xioTechnologies/DressCode-PCB/README.md

DressCode-PCB
=============

A sewable circuit for making LEDs respond to music.  [Firmware](https://github.com/xioTechnologies/DressCode-Firmware) source files are available on GitHub.  See [original post](http://www.x-io.co.uk/dresscode/) for more information.
