xioTechnologies/DressCode-PCB/DressCode BOM.xlsx

Name | Device | Qty | Unit price | Total price
R1, R2, R3, R4, R5, R6, R7, R8 | 2.2k, 0805 (http://uk.rs-online.com/web/p/surface-mount-fixed-resistors/2230477/) | 8 | £0.01 | £0.12
R9, R10, R11 | 100R, 0805 (http://uk.rs-online.com/web/p/surface-mount-fixed-resistors/2230297/) | 3 | £0.01 | £0.02
C1, C3, C4, C5, C6 | 10u, 0805 (http://uk.rs-online.com/web/p/ceramic-multilayer-capacitors/7236004/) | 5 | £0.07 | £0.37
C2 | 10n, 0805 (http://uk.rs-online.com/web/p/ceramic-multilayer-capacitors/2644371/) | 1 | £0.02 | £0.02
Q1, Q2, Q3 | 2N7002 (N-channel FET) (http://uk.rs-online.com/web/p/mosfet-transistors/7527773/) | 3 | £0.03 | £0.08
U3 | MCP6G02-E/SN (SGA) (http://uk.rs-online.com/web/p/programmable-gain-amplifiers/0402986/) | 1 | £0.31 | £0.31
U1, U2 | MCP6S21-I/SN (PGA) (http://uk.rs-online.com/web/p/programmable-gain-amplifiers/0403193/) | 2 | £0.69 | £1.37
M1 | Microphone (http://uk.rs-online.com/web/p/condenser-microphone-components/7243134/) | 1 | £0.46 | £0.46
M2 | Microphone (https://uk.rs-online.com/web/p/condenser-microphone-components/7243122/) | 1 | £0.56 | £0.56
U4 | PIC24FV16KA304-I/PT (http://uk.rs-online.com/web/p/microcontrollers/7421176/) | 1 | £1.91 | £1.91
U5 | MCP73832T-2ACI/OT (battery charger) (http://uk.rs-online.com/web/p/battery-charge-controller-ics/7386364/) | 1 | £0.38 | £0.38
USB1 | Micro USB socket (http://uk.rs-online.com/web/p/micro-usb-connectors/7025475/) | 1 | £0.52 | £0.52
JST1 | JST battery connector (https://www.sparkfun.com/products/8612) | 1 | £0.49 | £0.49
SW1 | Slide switch (http://uk.farnell.com/c-k-components/pcm12smtr/switch-spdt-0-3a-6vdc-smd/dp/9575146RL) | 1 | £0.62 | £0.62
 |  |  | Total: | £7.24
Only one microphone should be populated, M1 or M2
