xioTechnologies/DressCode-PCB/DressCode Schematic.pdf

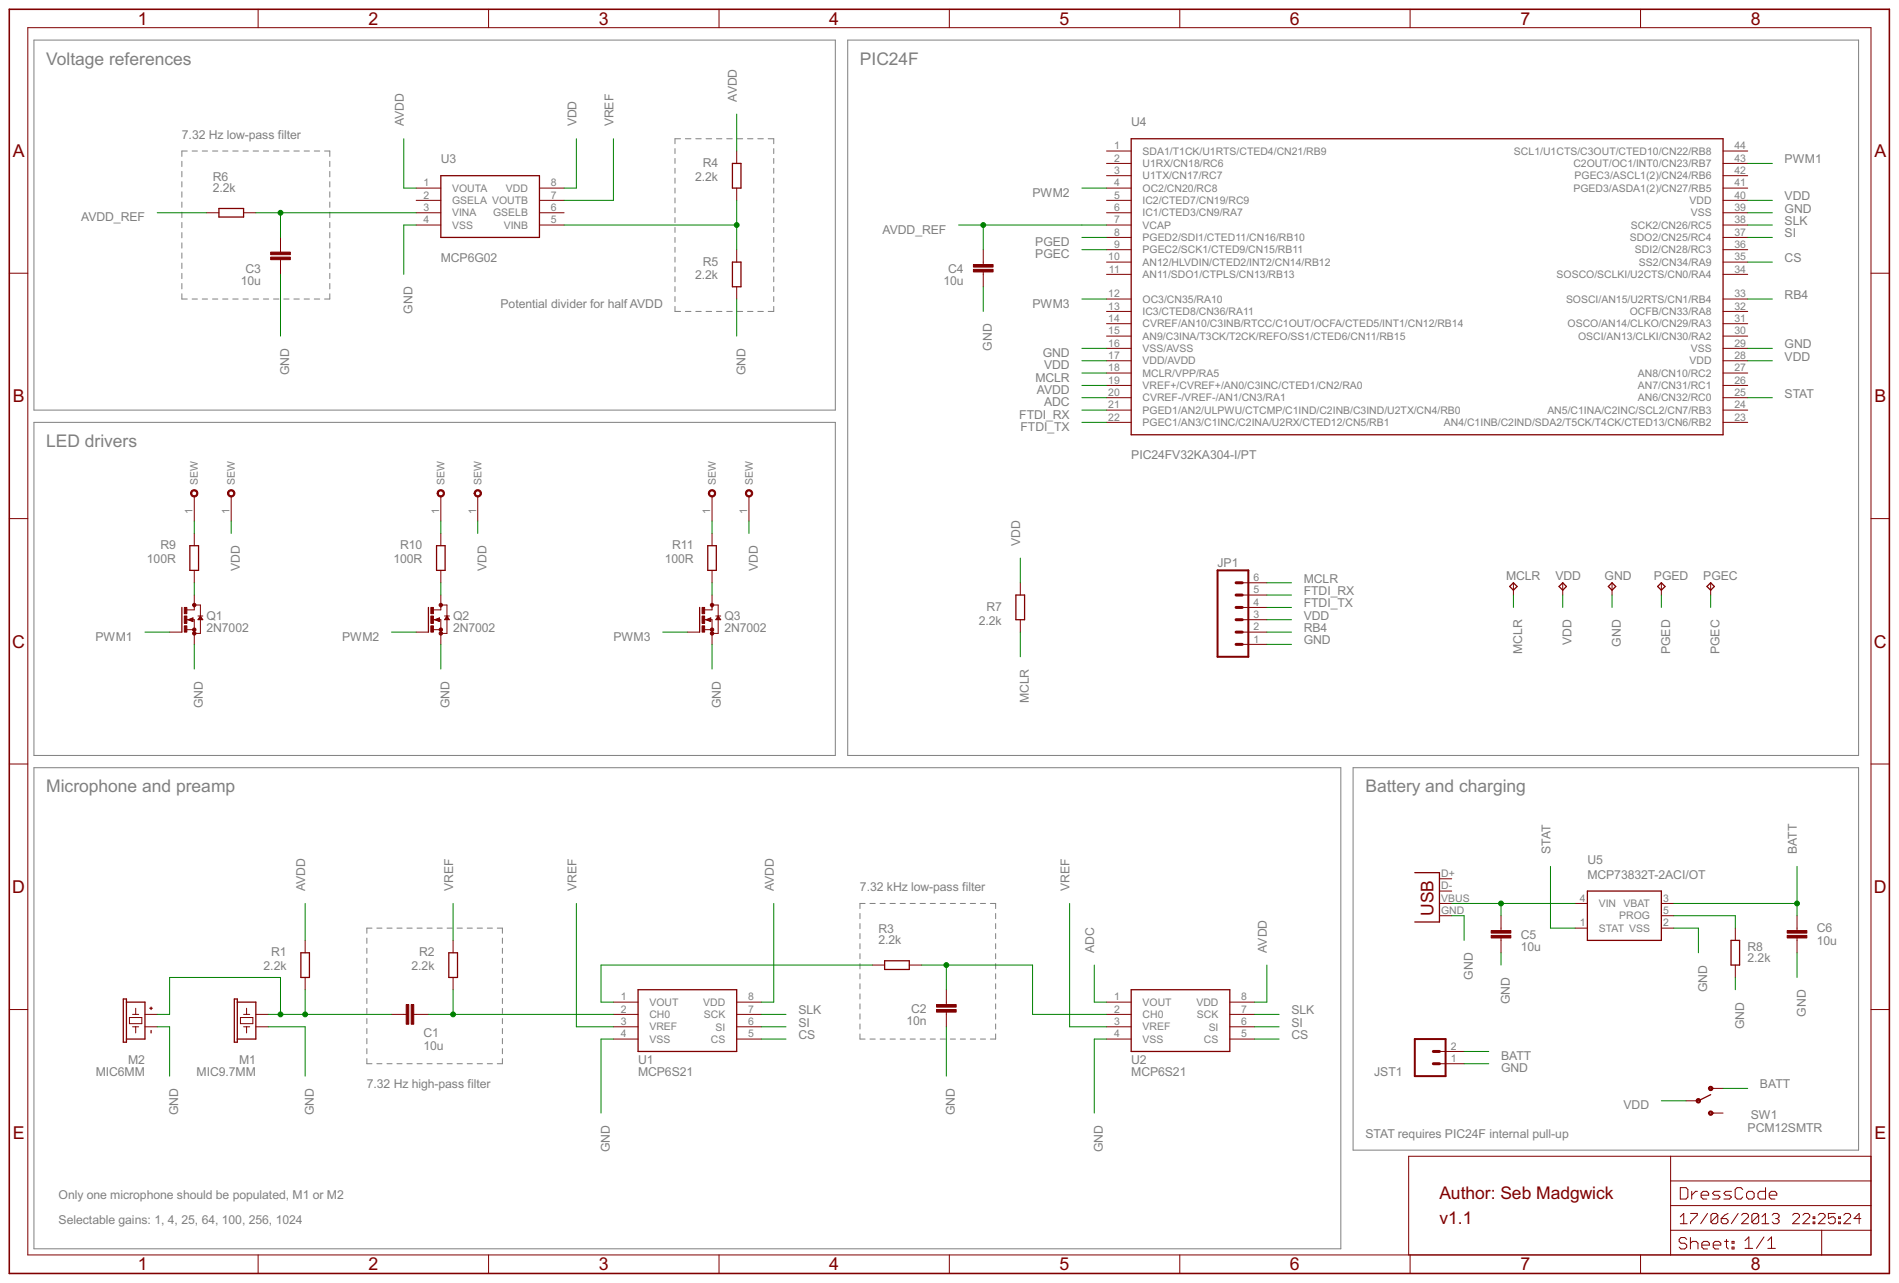
[picture p1: page 1]

7.32 Hz low-pass filter

Potential divider for half AVDD

BATT BATT Author: Seb Madgwick

7.32 kHz low-pass filter

7.32 Hz high-pass filter
