xioTechnologies/DressCode-PCB/DressCode PCB.pdf

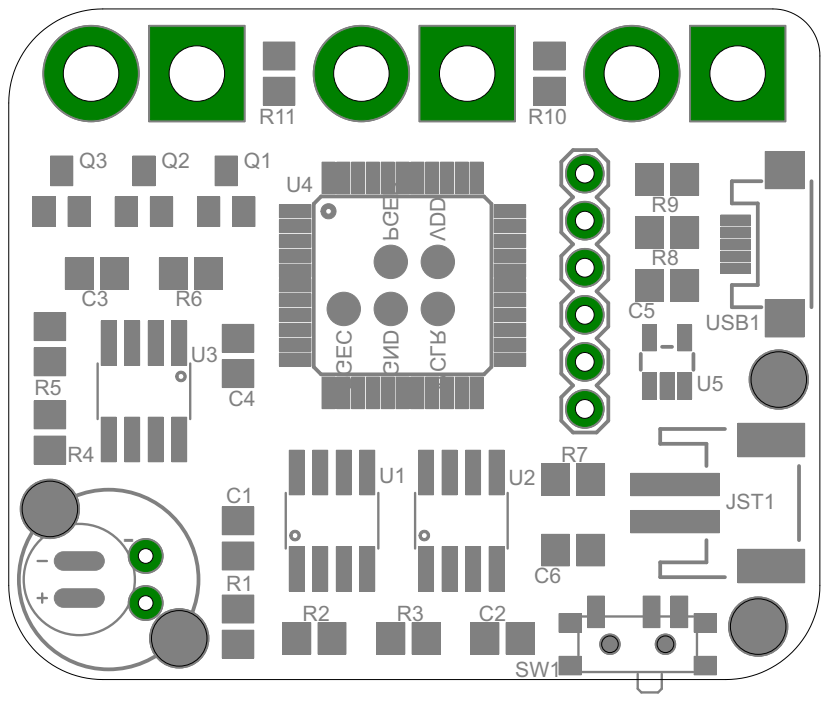
[picture p2: page 1]
