xioTechnologies/DressCode-PCB/DressCode.brd

## EAGLE design DressCode.brd (2013-06-20)

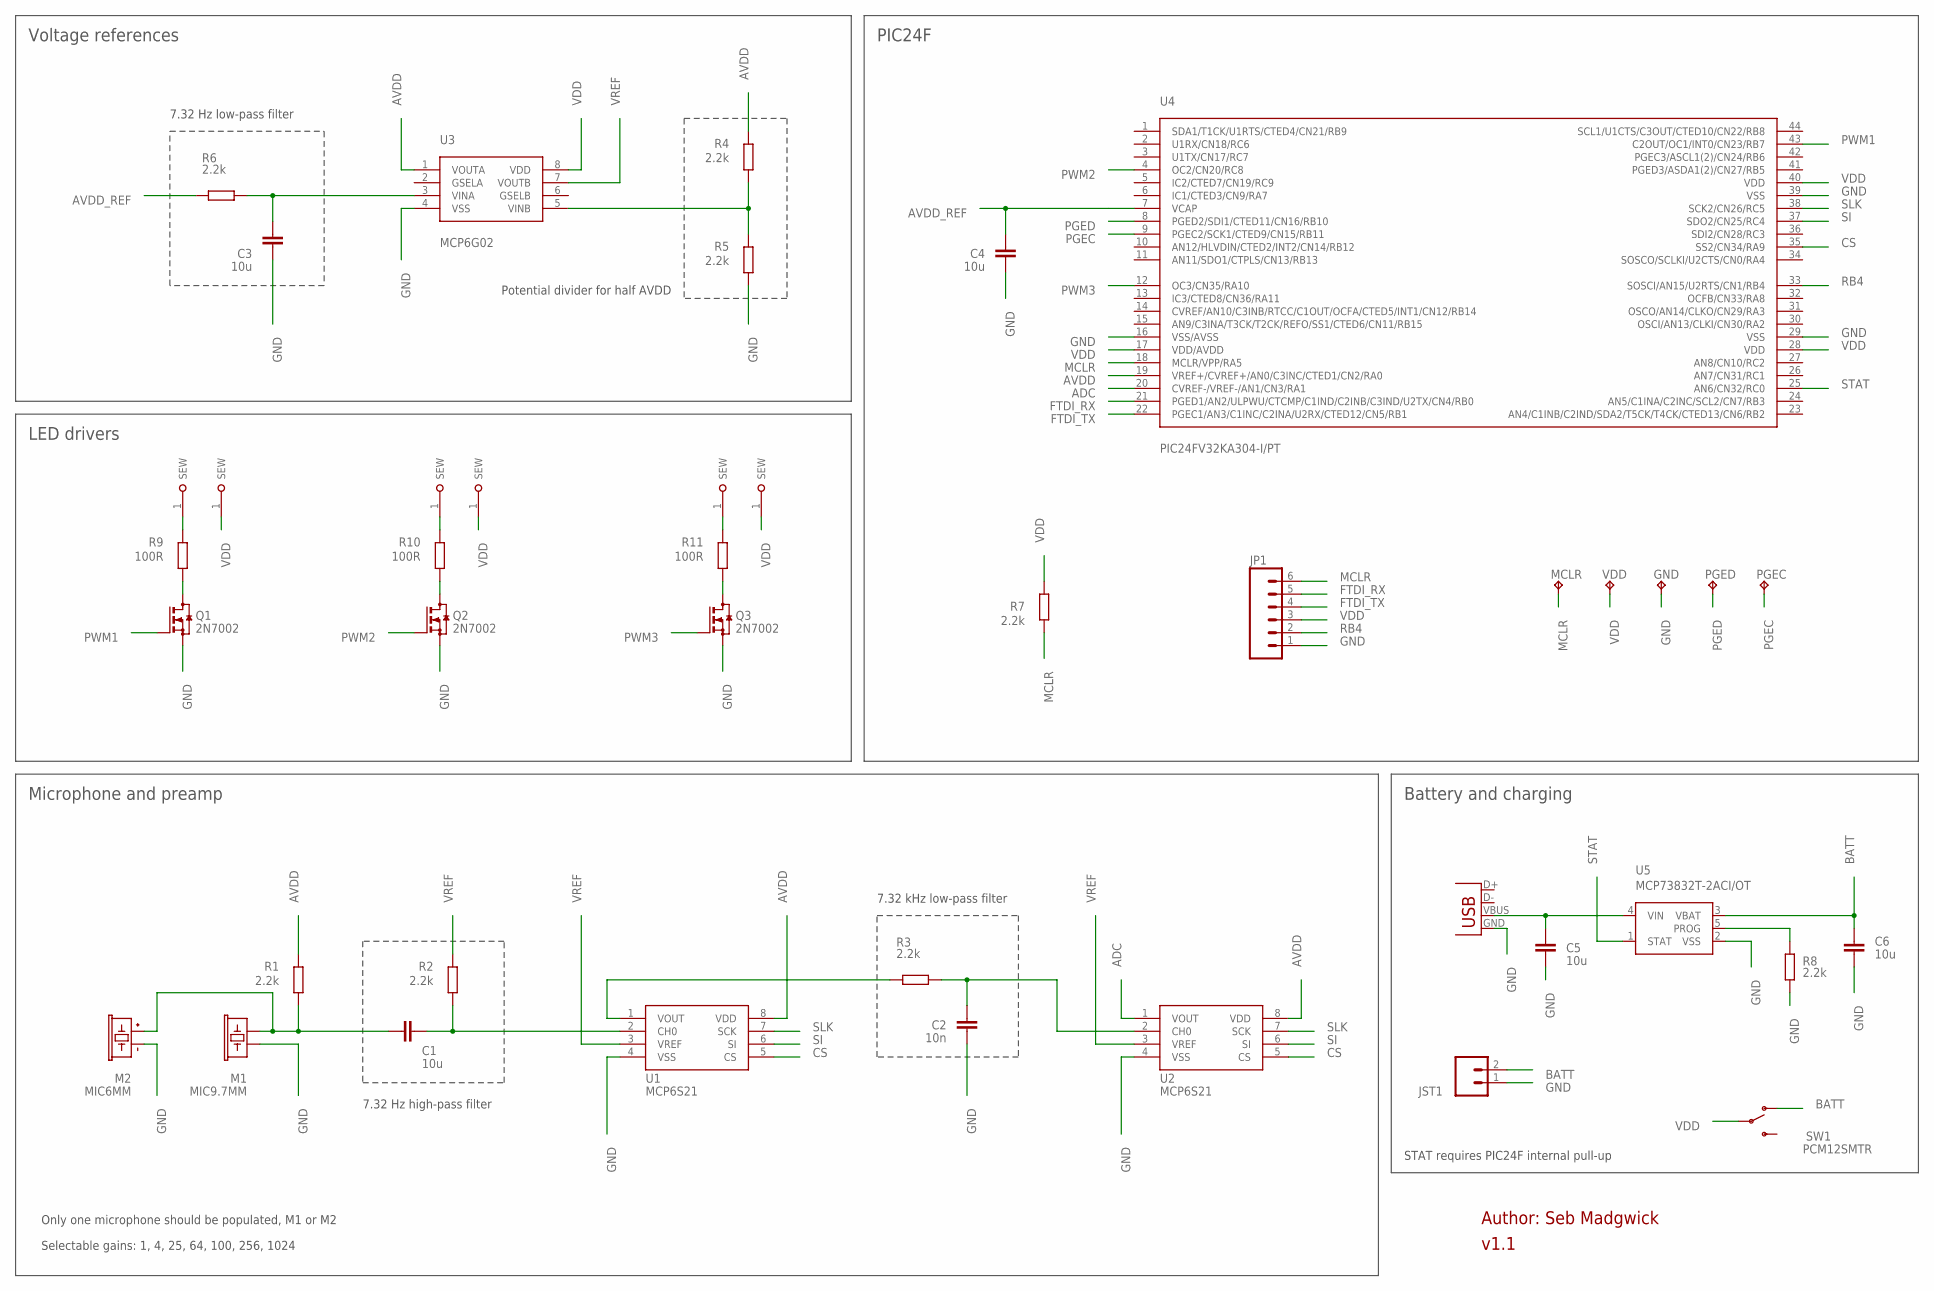
[picture p3: schematic DressCode.sch]

Parts:
C1, C3, C4, C5, C6: 10u; C0805
C2: 10n; C0805
GND: TPTP16R; TP16R
JP1: M06SIP; 1X06
JST1: M02-JST-2MM-SMT; JST-2-SMD
M1: MIC9.7MM; MIC-9.7MM
M2: MIC6MM; MIC-SMD
MCLR: TPTP16R; TP16R
PGEC: TPTP16R; TP16R
PGED: TPTP16R; TP16R
Q1, Q2, Q3: 2N7002; SOT23
R1, R2, R3, R4, R5, R6, R7, R8: 2.2k; R0805
R9, R10, R11: 100R; R0805
SW1: PCM12SMTR
U1, U2: MCP6S21; SOIC-8
U3: MCP6G02; SOIC-8
U4: PIC24FV32KA304-I/PT; TQFP44
U5: MCP73832T-2ACI/OT; SOT23-5
U$4, U$5, U$6: DRESSCODE_SEW_PADC; DRESSCODE_SEW_PAD_CIRC
U$7, U$8, U$10: DRESSCODE_SEW_PADS; DRESSCODE_SEW_PAD_SQR
USB1: USB-MICROB
VDD: TPTP16R; TP16R

Connections:
ADC: U2.1 (VOUT), U4.20 (CVREF-/VREF-/AN1/CN3/RA1)
AVDD: R1.2, R4.2, U1.8 (VDD), U2.8 (VDD), U3.1 (VOUTA), U4.19 (VREF+/CVREF+/AN0/C3INC/CTED1/CN2/RA0)
AVDD_REF: C4.2, R6.1, U4.7 (VCAP)
BATT: C6.2, JST1.2, SW1.1 (O), U5.3 (VBAT)
CS: U1.5 (CS), U2.5 (CS), U4.35 (SS2/CN34/RA9)
FTDI_RX: JP1.5, U4.21 (PGED1/AN2/ULPWU/CTCMP/C1IND/C2INB/C3IND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)
FTDI_TX: JP1.4, U4.22 (PGEC1/AN3/C1INC/C2INA/U2RX/CTED12/CN5/R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)
GND: C2.2, C3.1, C4.1, C5.1, C6.1, GND.TP, JP1.1, JST1.1, M1.2, M2.-, Q1.2 (S), Q2.2 (S), Q3.2 (S), R5.1, R8.1, U1.4 (VSS), U2.4 (VSS), U3.4 (VSS), U4.16 (VSS/AVSS), U4.29 (VSS), U4.39 (VSS), U5.2 (VSS), USB1.GND
MCLR: JP1.6, MCLR.TP, R7.1, U4.18 (MCLR/VPP/RA5)
unnamed: C1.1, M1.1, M2.+, R1.1
unnamed: C1.2, R2.1, U1.2 (CH0)
unnamed: C2.1, R3.2, U2.2 (CH0)
unnamed: R3.1, U1.1 (VOUT)
unnamed: C3.2, R6.2, U3.3 (VINA)
unnamed: R4.1, R5.2, U3.5 (VINB)
unnamed: Q1.3 (D), R9.1
unnamed: Q2.3 (D), R10.1
unnamed: Q3.3 (D), R11.1
unnamed: R9.2, U$7.1
unnamed: R10.2, U$8.1
unnamed: R11.2, U$10.1
unnamed: R8.2, U5.5 (PROG)
PGEC: PGEC.TP, U4.9 (PGEC2/SCK1/CTED9/CN15/RB11)
PGED: PGED.TP, U4.8 (PGED2/SDI1/CTED11/CN16/RB10)
PWM1: Q1.1 (G), U4.43 (C2OUT/OC1/INT0/CN23/RB7)
PWM2: Q2.1 (G), U4.4 (OC2/CN20/RC8)
PWM3: Q3.1 (G), U4.12 (OC3/CN35/RA10)
RB4: JP1.2, U4.33 (SOSCI/AN15/U2RTS/CN1/RB4)
SI: U1.6 (SI), U2.6 (SI), U4.37 (SDO2/CN25/RC4)
SLK: U1.7 (SCK), U2.7 (SCK), U4.38 (SCK2/CN26/RC5)
STAT: U4.25 (AN6/CN32/RC0), U5.1 (STAT)
USB1: C5.2, U5.4 (VIN), USB1.VBUS
VDD: JP1.3, R7.2, SW1.2, U3.8 (VDD), U4.17 (VDD/AVDD), U4.28 (VDD), U4.40 (VDD), U$4.1, U$5.1, U$6.1, VDD.TP
VREF: R2.2, U1.3 (VREF), U2.3 (VREF), U3.7 (VOUTB)

Notes on the sheet:
7.32 kHz low-pass filter
7.32 Hz high-pass filter
Microphone and preamp
Selectable gains: 1, 4, 25, 64, 100, 256, 1024
Voltage references
Potential divider for half AVDD
7.32 Hz low-pass filter
LED drivers
PIC24F
Battery and charging
Author: Seb Madgwick
Only one microphone should be populated, M1 or M2
v1.1
STAT requires PIC24F internal pull-up

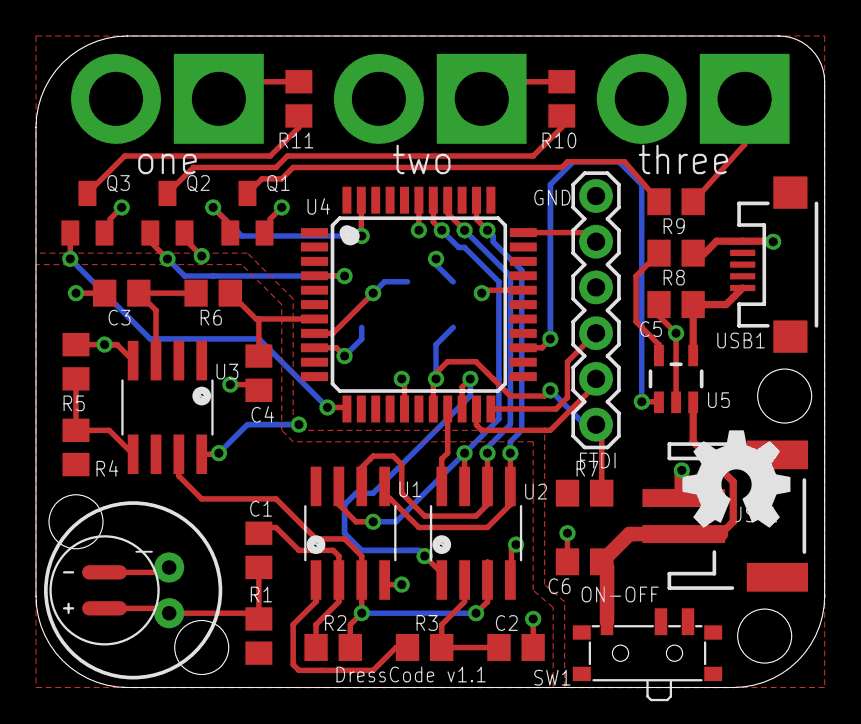
[picture p4: board DressCode.brd from above]

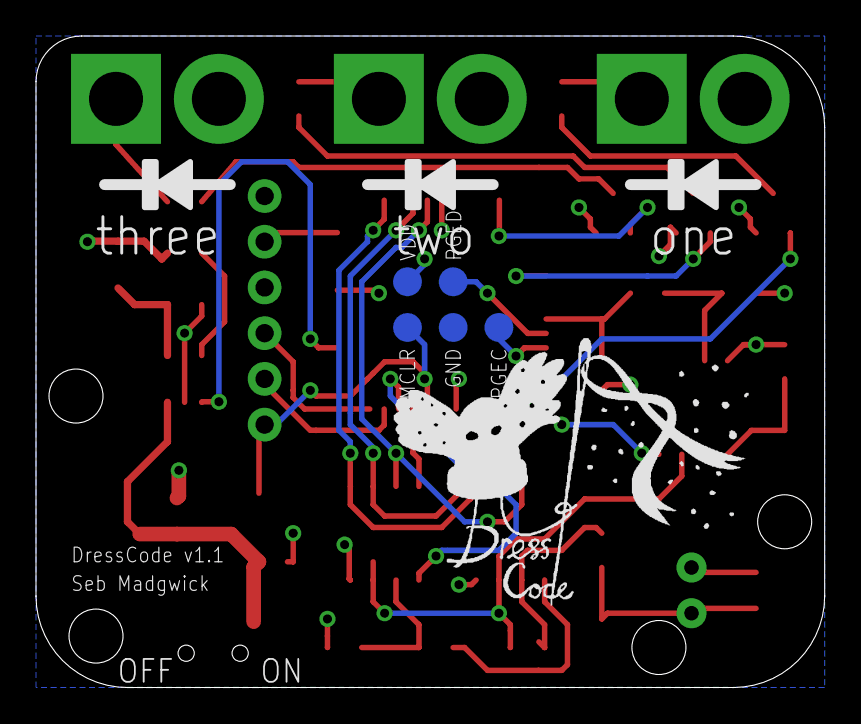
[picture p5: board DressCode.brd from below]

Board: 2 copper layers, 43.8 x 36.2 mm, 44 parts (6 on the bottom side), 34 nets.

Other parts of the board:
U$1: OSHW_LOGO_6MM_BOTTOM
U$9: DRESSCODE_LOGO
