xioTechnologies/DressCode-PCB/(commit log)

2013-04-29 project files added
    [DressCode BOM.xlsx, DressCode.brd, DressCode.sch]
2013-05-06 JST connector added for LiPo power
    [DressCode.brd, DressCode.sch]
2013-05-07 added .MILL file to Gerbers
2013-05-07 design now includes USB charger
    [DressCode BOM.xlsx, DressCode.brd, DressCode.sch]
2013-05-10 added power switch
    [DressCode BOM.xlsx, DressCode.brd, DressCode.sch]
2013-05-11 added OSH logo
    [DressCode.brd]
2013-05-11 irrelevant change to ground polygon
    [DressCode.brd]
2013-06-20 Add C2 to BOM and USB rework photo
    [DressCode BOM.xlsx]
2013-06-20 Fix USB connection error
    [DressCode.brd, DressCode.sch]
2013-07-06 Correct link to 10uF capacitor in BOM
    [DressCode BOM.xlsx]
