xioTechnologies/DressCode-PCB/(notices)

Notices in the files:
parts and their libraries:
SparkFun_08_2011: Licensing: CC v3.0 Share-Alike You are welcome to use this library for commercial purposes.
